mwuerms/balancer_hw/kicad/bal01_02_bom.ods

Bal01 & bal02 – combined BOM
2026-05-03
 |  |  |  |  | Nb PCBs | 4
Designator | Qnt | Value | Footprint | PCB | Mouser | nB PCBs Qnt | Order Qnt
C1 | 1 | 10uF | 0805mil | bal02 | 187-CL21A106KOQNNNF | 4 | 10
C1, C2 | 2 | 1uF | 0603mil | bal01 | 791-SH18B105K160CT | 8 | 10
C2, C5, C6, C7 | 4 | 100nF | 0603mil | bal02 | 187-CL10A104KA8NNNC | 16 | 20
C3, C4 | 2 | 100uF/25V | WCAP-ATG8 | bal02 | 710-860010473007 | 8 | 4
D1 | 1 | BAT54J | D_SOD-323F | bal02 | 511-BAT54JFILM | 4 | 10
D2, D3 | 2 | 1N4148WT | D_SOD-523 | bal02 | 621-1N4148WT | 8 | 10
IC1 | 1 | MA702GQ-P | QFN-16 | bal01 | 946-MA702GQ-Z | 4 | 5
IC1 | 1 | nucleo32-L432 | nucleo32 | bal02 | 511-NUCLEO-L412KB | 4 | 0
IC2 | 1 | TLV76033DBZR | SOT95P237X112-3N | bal01 | 595-TLV76033DBZR | 4 | 4
IC2 | 1 | nRF24L01_SMD_MODULE | nRF24L01_SMD_MODULE | bal02 | - | 4 | 0
IC3 | 1 | MPU9250_SMD_MODULE | MPU9250_SMD_MODULE | bal02 | - | 4 | 0
IC4 | 1 | M24C16-FMN6TP | SOIC127P600X175-8N | bal02 | 511-M24C16-FMN6TP | 4 | 2
IC5 | 1 | SN65HVD230DR | SOT127P600X175-8N | bal02 | 595-SN65HVD230DR | 4 | 4
IC6 | 1 | TLV76050DBZR | SOT95P237X112-3N | bal02 | 595-TLV76050DBZR | 4 | 4
R5, R6 | 2 | 4k7 | 0603mil | bal02 | 279-CRGCQ0603F4K7 | 8 | 20
R8 | 1 | 120R | 0603mil | bal02 | 754-RG1608P-121DT5 | 4 | 20
