mwuerms/balancer_hw/(list of files, cad)

Other CAD files:
cad/bal01/leg.scad
cad/bal02/leg.scad
cad/bal01/bal01.scad
cad/bal02/bal02.scad
