mwuerms/balancer_hw/kicad/bal01/rev0/bal01_rev0_schematics.pdf

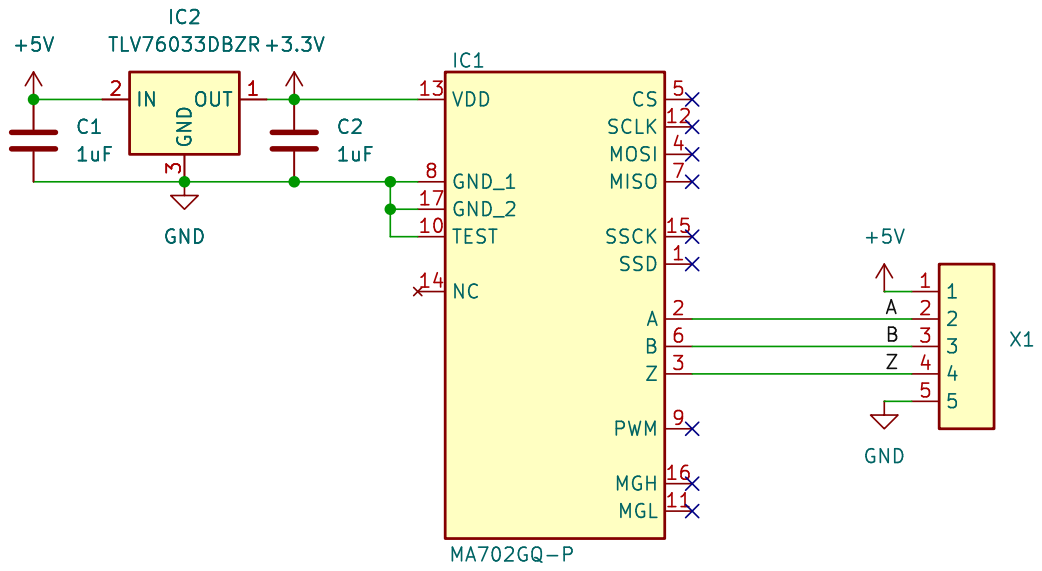
[picture p1: page 1]

File: bal01.kicad_sch Sheet: /
Id: 1/1 Title: sensor pcb
