mwuerms/balancer_hw/kicad/bal02/rev0/bal02_rev0_schematics.pdf

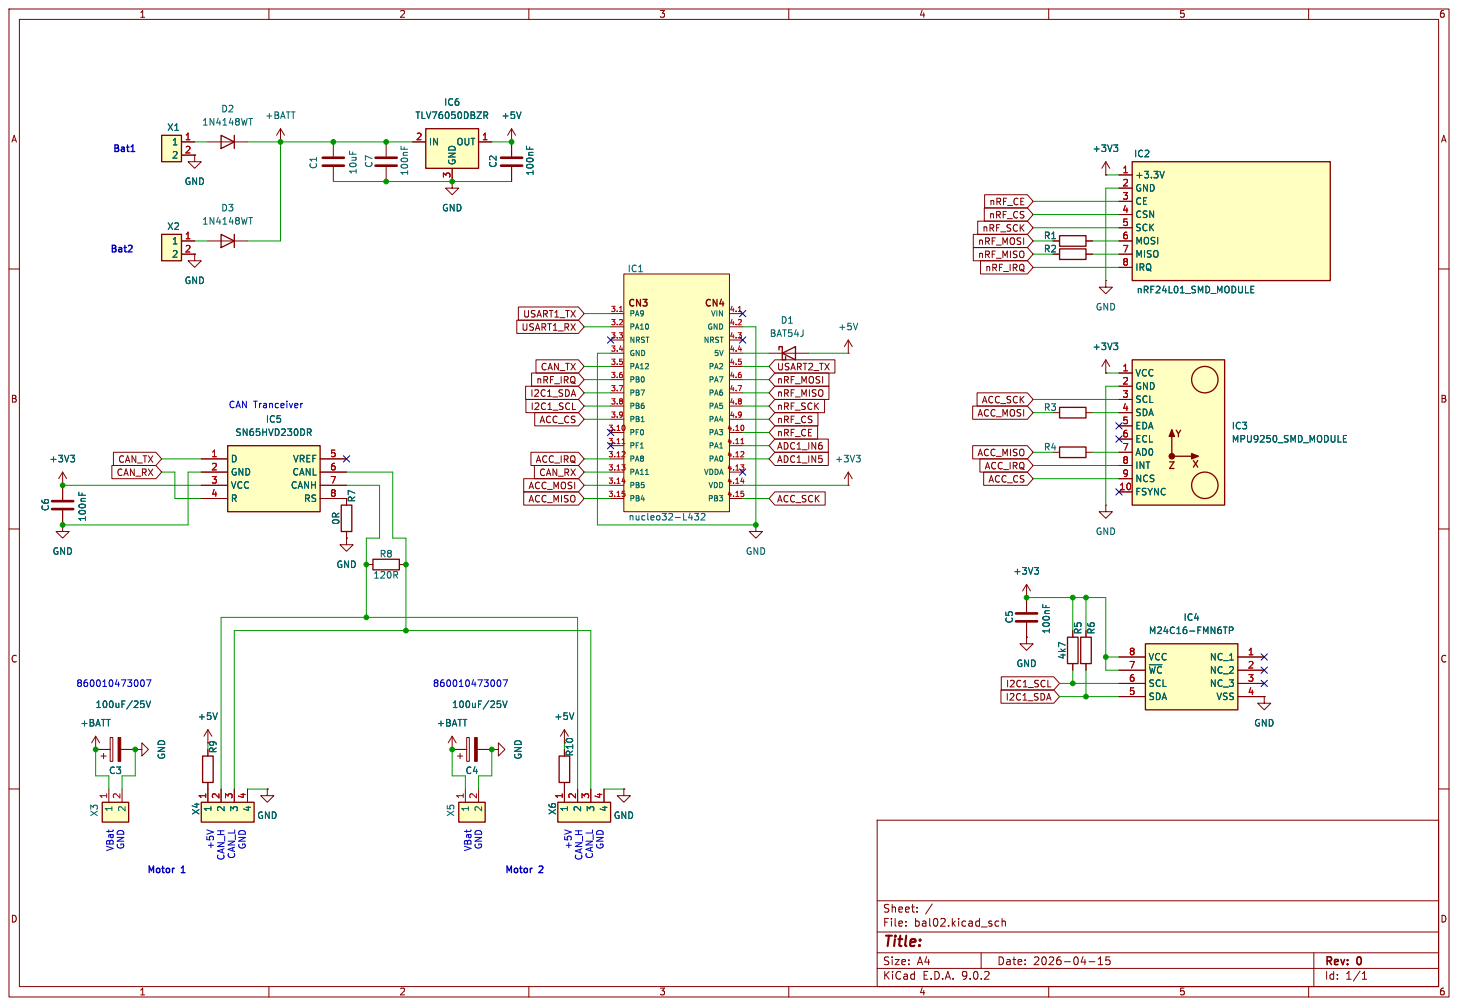
[picture p2: page 1]

+3.3V 1 GND 2 CE 3 CSN 4 SCK 5 MOSI 6 MISO 7
INT 8 NCS 9 FSYNC 10 R2 R1

IRQ 8 +3V3

VCC 1 GND 2 SCL 3 SDA 4 EDA 5 ECL 6 AD0 7

Id: 1/1 Title: File: bal02.kicad_sch Sheet: / D
