mwuerms/balancer_hw/kicad/bal01/bal01.kicad_pcb

## KiCad design kicad/bal01/bal01.kicad_pcb (2026-04-30)

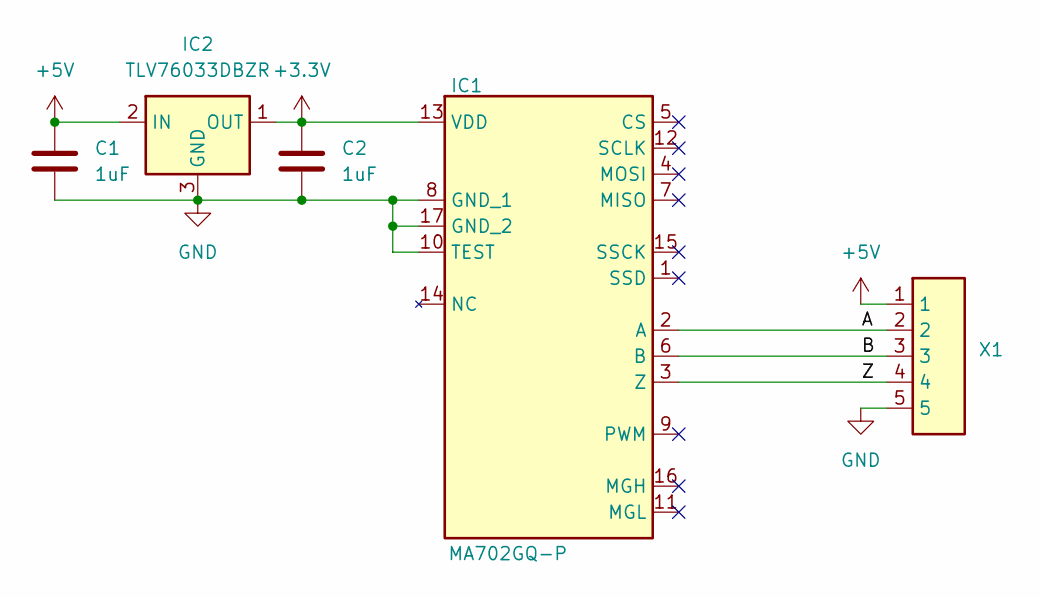
[picture p3: schematic bal01.kicad_sch, sensor pcb]

Parts:
C1, C2: 1uF; C_0603_1608Metric
IC1: MA702GQ-P; QFN-16; Manufacturer_Part_Number MA702GQ-P; Mouser Part Number 946-MA702GQ-P
IC2: TLV76033DBZR; SOT95P237X112-3N; Manufacturer_Part_Number TLV76050DBZR; Mouser Part Number 595-TLV76050DBZR
X1: H5_Pads_1.27mm

Connections:
+3.3V: C2.1, IC1.13 (VDD), IC2.1 (OUT)
+5V: C1.1, IC2.2 (IN), X1.1
/A: IC1.2 (A), X1.2
/B: IC1.6 (B), X1.3
/Z: IC1.3 (Z), X1.4
GND: C1.2, C2.2, IC1.8 (GND_1), IC1.10 (TEST), IC1.17 (GND_2), IC2.3 (GND), X1.5

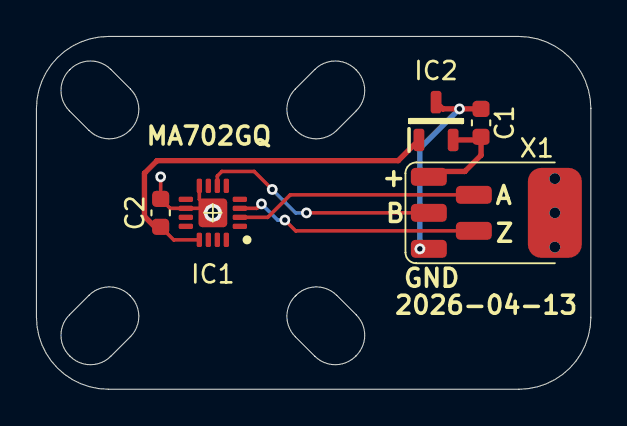
[picture p4: board bal01.kicad_pcb from above]

Board: 2 copper layers, 30.8 x 19.6 mm, 5 parts (0 on the bottom side), 6 nets.
