mwuerms/balancer_hw/kicad/bal02/bal02.kicad_pcb

## KiCad design kicad/bal02/bal02.kicad_pcb (2026-04-30)

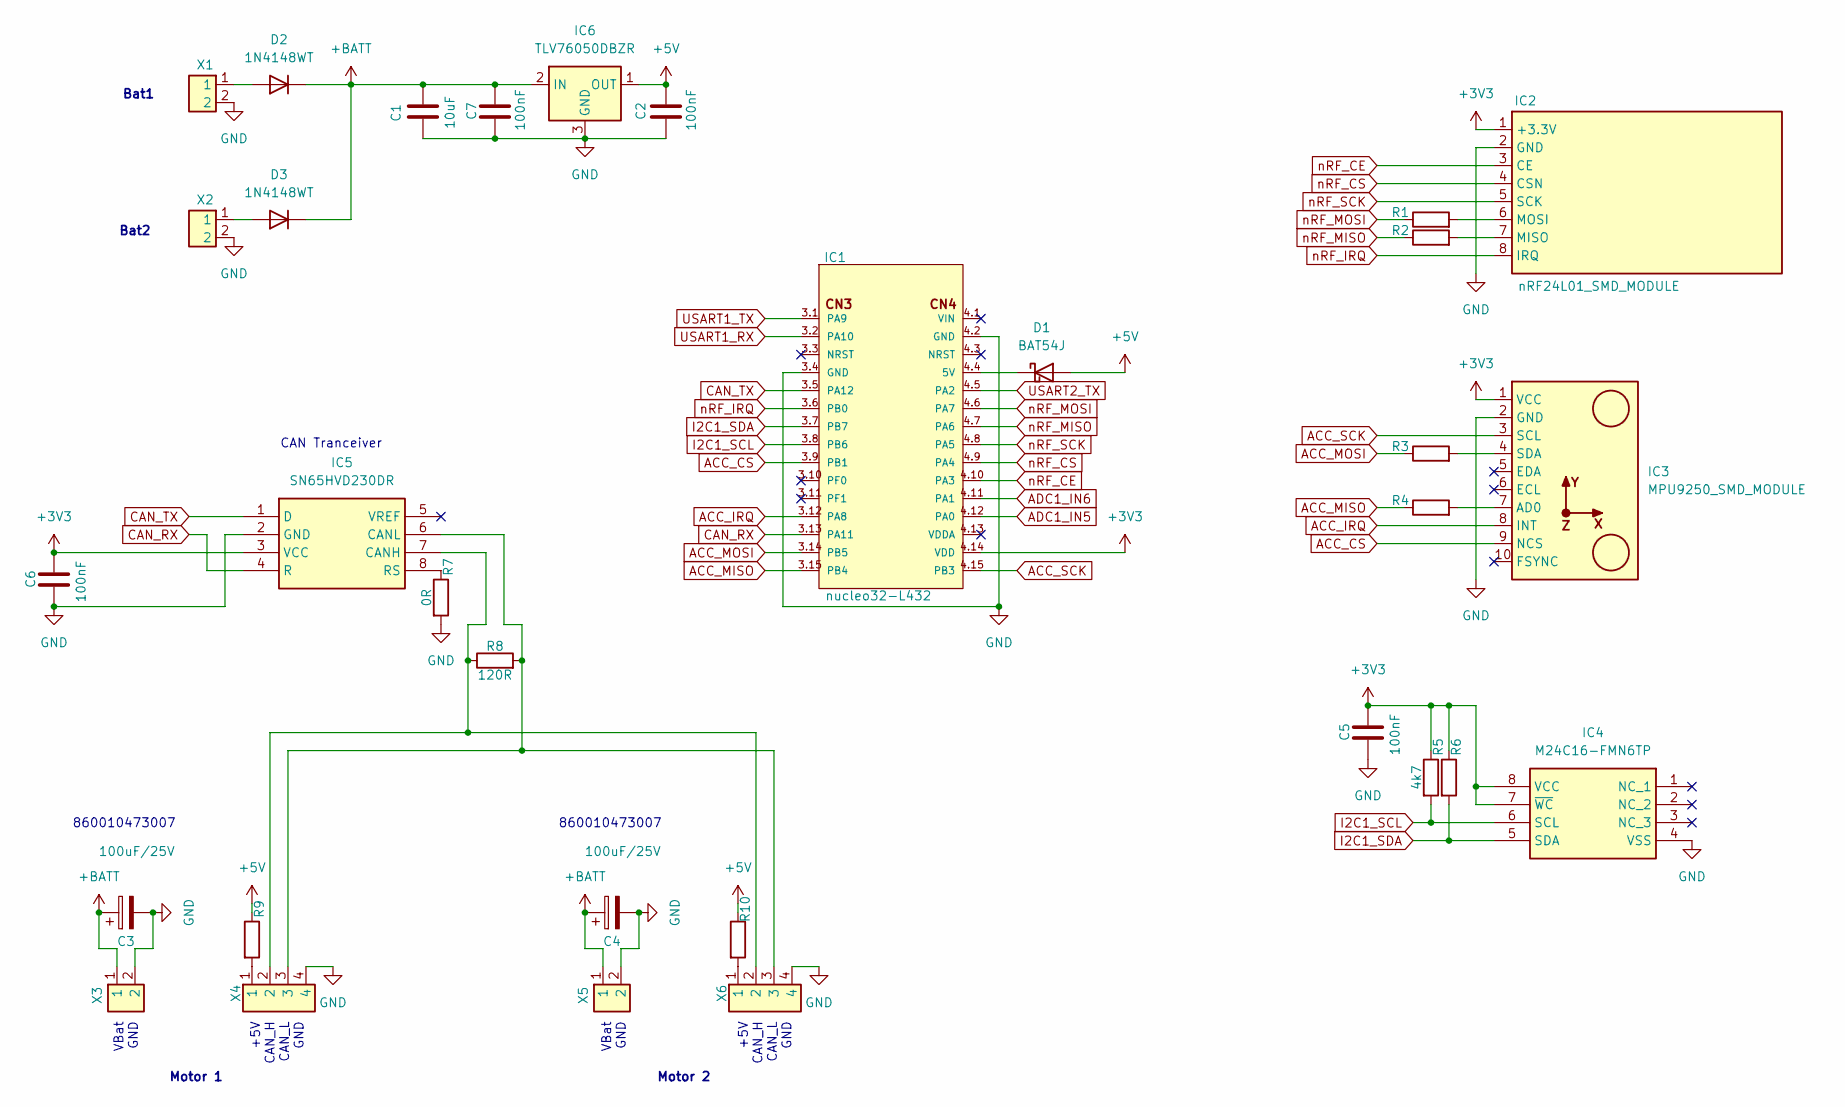
[picture p5: schematic bal02.kicad_sch]

Parts:
C1: 10uF; C_0805_2012Metric
C2, C5, C6, C7: 100nF; C_0603_1608Metric
C3, C4: 100uF/25V; WCAP-ATG8
D1: BAT54J; D_SOD-323F
D2, D3: 1N4148WT; D_SOD-523
IC1: nucleo32-L432; nucleo32; PARTREV 3
IC2: nRF24L01_SMD_MODULE
IC3: MPU9250_SMD_MODULE
IC4: M24C16-FMN6TP; SOIC127P600X175-8N; Manufacturer_Part_Number M24C16-FMN6TP; Mouser Part Number 511-M24C16-FMN6TP
IC5: SN65HVD230DR; SOT127P600X175-8N; Manufacturer_Part_Number SN65HVD230DR; Mouser Part Number 595-SN65HVD230DR
IC6: TLV76050DBZR; SOT95P237X112-3N; Manufacturer_Part_Number TLV76050DBZR; Mouser Part Number 595-TLV76050DBZR
R1, R2, R3, R4, R9, R10: R; R_0402_1005Metric
R5, R6: 4k7; R_0603_1608Metric
R7: 0R; R_0603_1608Metric
R8: 120R; R_0603_1608Metric
X1, X2, X3, X5: H2_100mil
X4, X6: H4_50mil

Connections:
+3V3: C5.1, C6.1, IC1.4.14 (VDD), IC2.1 (+3.3V), IC3.1 (VCC), IC4.7 (~WC), IC4.8 (VCC), IC5.3 (VCC), R5.1, R6.1
+5V: C2.1, D1.2 (A), IC6.1 (OUT), R9.1, R10.1
+BATT: C1.1, C3.1, C4.1, C7.1, D2.1 (K), D3.1 (K), IC6.2 (IN), X3.1, X5.1
ACC_CS: IC1.3.9 (PB1), IC3.9 (NCS)
ACC_IRQ: IC1.3.12 (PA8), IC3.8 (INT)
ACC_MISO: IC1.3.15 (PB4), R4.1
ACC_MOSI: IC1.3.14 (PB5), R3.1
ACC_SCK: IC1.4.15 (PB3), IC3.3 (SCL)
ADC1_IN5: IC1.4.12 (PA0)
ADC1_IN6: IC1.4.11 (PA1)
CAN_RX: IC1.3.13 (PA11), IC5.4 (R)
CAN_TX: IC1.3.5 (PA12), IC5.1 (D)
GND: C1.2, C2.2, C3.2, C4.2, C5.2, C6.2, C7.2, IC1.3.4 (GND), IC1.4.2 (GND), IC2.2 (GND), IC3.2 (GND), IC4.4 (VSS), IC5.2 (GND), IC6.3 (GND), R7.2, X1.2, X2.2, X3.2, X4.4, X5.2, X6.4
I2C1_SCL: IC1.3.8 (PB6), IC4.6 (SCL), R5.2
I2C1_SDA: IC1.3.7 (PB7), IC4.5 (SDA), R6.2
unnamed: D1.1 (K), IC1.4.4 (5V)
unnamed: D2.2 (A), X1.1
unnamed: D3.2 (A), X2.1
unnamed: IC2.7 (MISO), R2.2
unnamed: IC2.6 (MOSI), R1.2
unnamed: IC3.7 (AD0), R4.2
unnamed: IC3.4 (SDA), R3.2
unnamed: IC5.7 (CANH), R8.1, X4.2, X6.2
unnamed: IC5.6 (CANL), R8.2, X4.3, X6.3
unnamed: IC5.8 (RS), R7.1
unnamed: R9.2, X4.1
unnamed: R10.2, X6.1
USART1_RX: IC1.3.2 (PA10)
USART1_TX: IC1.3.1 (PA9)
USART2_TX: IC1.4.5 (PA2)
nRF_CE: IC1.4.10 (PA3), IC2.3 (CE)
nRF_CS: IC1.4.9 (PA4), IC2.4 (CSN)
nRF_IRQ: IC1.3.6 (PB0), IC2.8 (IRQ)
nRF_MISO: IC1.4.7 (PA6), R2.1
nRF_MOSI: IC1.4.6 (PA7), R1.1
nRF_SCK: IC1.4.8 (PA5), IC2.5 (SCK)

Notes on the sheet:
Bat2
Bat1
860010473007
+5V CAN_H CAN_L GND
VBat GND
Motor 2
CAN Tranceiver
Motor 1

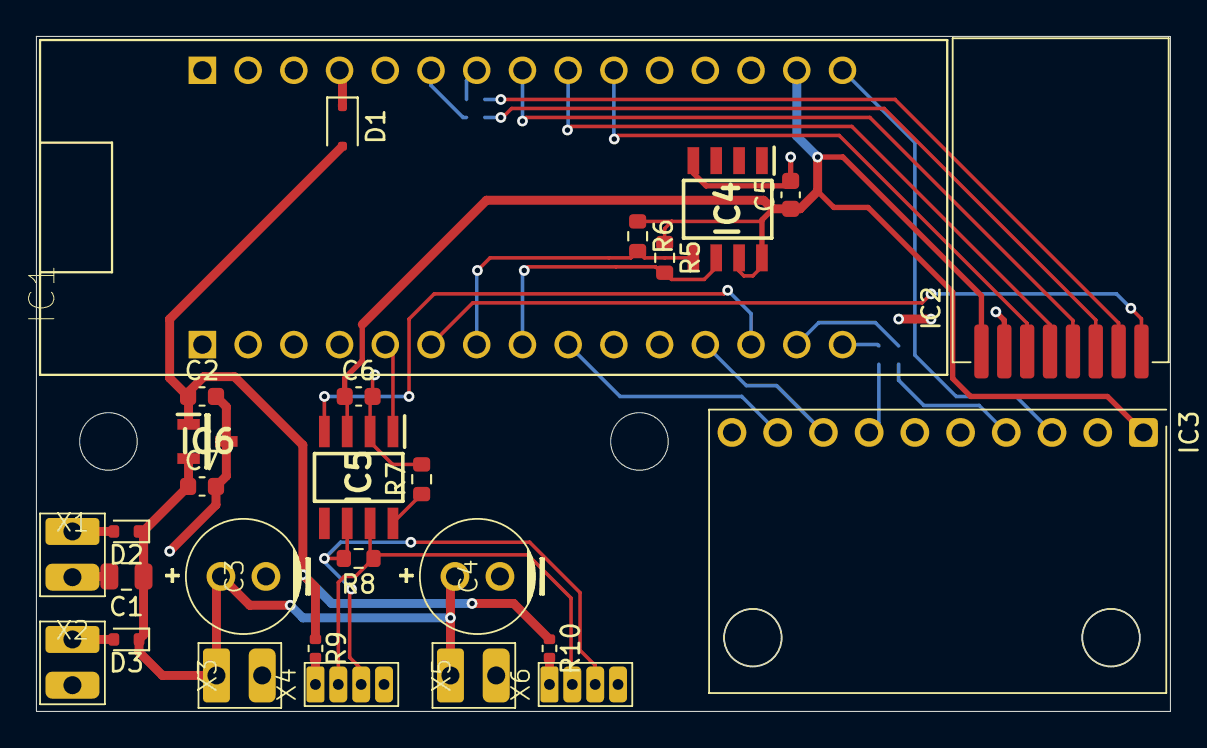
[picture p6: board bal02.kicad_pcb from above]

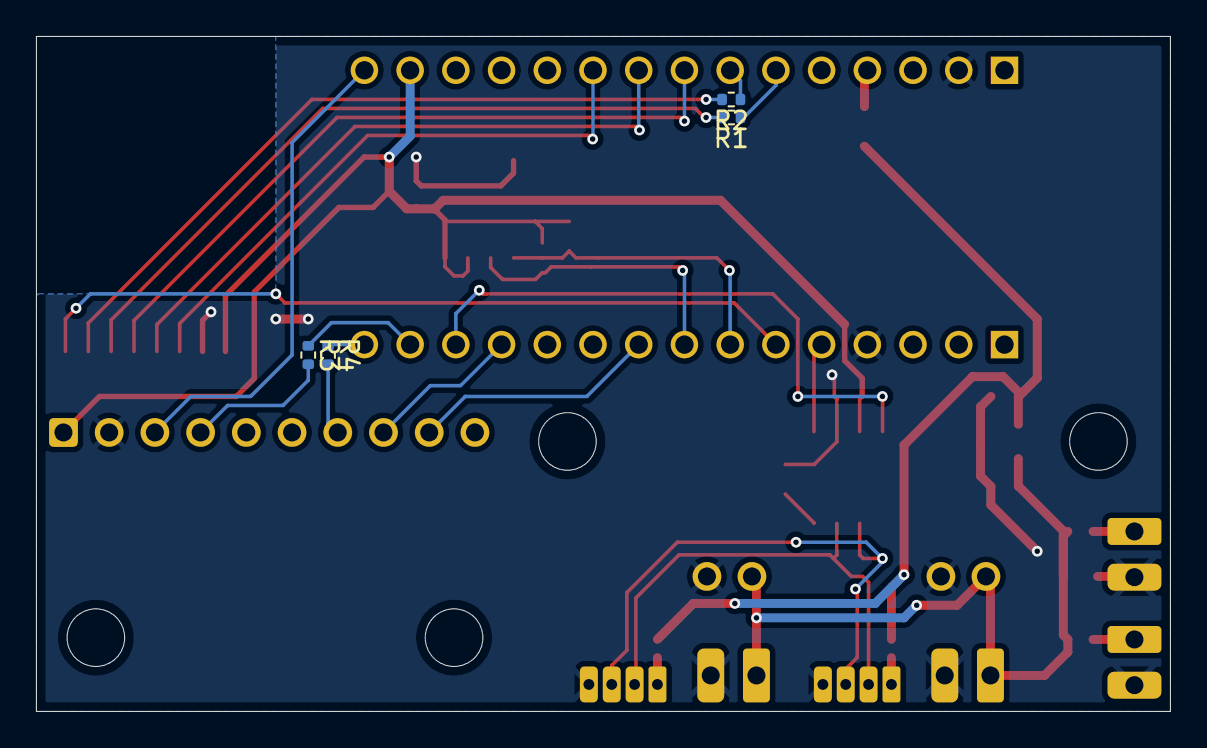
[picture p7: board bal02.kicad_pcb from below]

Board: 2 copper layers, 63.0 x 37.5 mm, 32 parts (4 on the bottom side), 31 nets.
