mwuerms/balancer_hw/(commit log)

2026-04-30 added cad bal01 + bal02 from balancer repo
    [bal01.scad, bal02.scad, bluepill.scad, electronics_parts.scad, g431b_esc1.scad, leg.scad, mechanics_parts.scad, mpu.scad]
2026-04-30 also added kicad files from old balancer repo
    [bal01.kicad_pcb, bal01.kicad_sch, bal02.kicad_pcb, bal02.kicad_sch, bom.csv]
2026-05-02 docs: combined BOM form bal01 & bal02 rev0 created, also additional docs like schematics + ibom
    [bal01_02_bom.ods, bal01_rev0_bom.csv, bal02_rev0_bom.csv]
2026-05-03 moved reused files to "lib"
    [electronics_parts.scad, mechanics_parts.scad, msr175holdarm.scad, printparts.scad, screws.scad]
2026-05-03 scad: added pcbs and modules
2026-05-06 added a teststand for bal02 also added bal01_MA702 part
    [bal02teststand.scad]
